EvgeniyaGo/Evgeniya-Golubeva-ADHD-Trainer/electrical_schematic.png

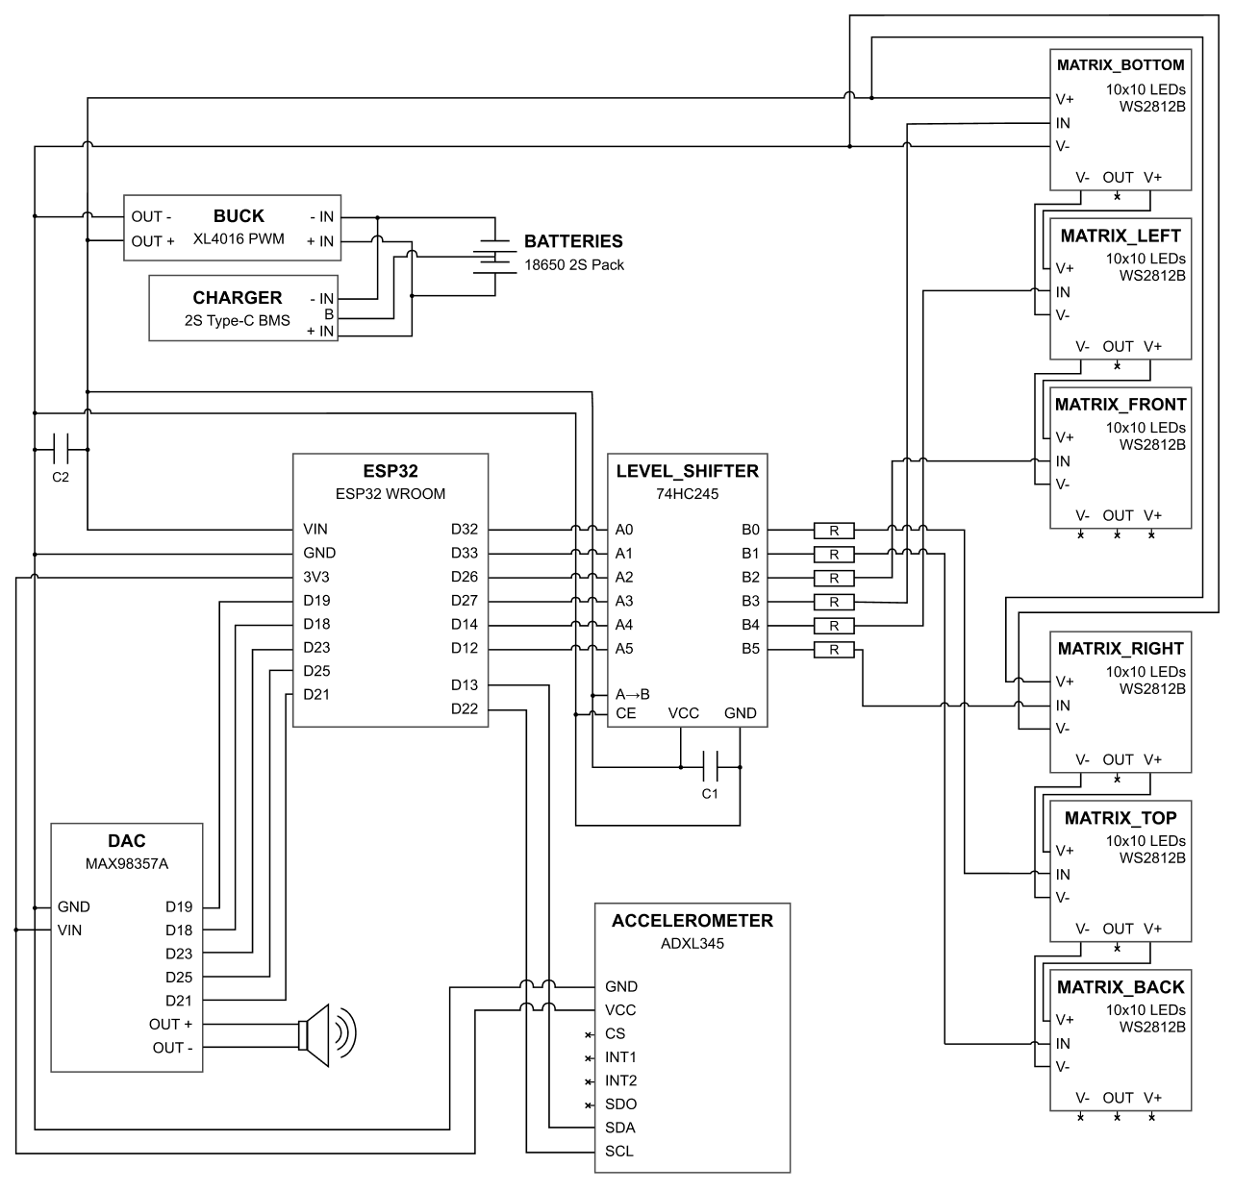
electrical_schematic.png
