EvgeniyaGo/Evgeniya-Golubeva-ADHD-Trainer/PCB/base-schematic-V3/base-schematic-02.kicad_pcb

## KiCad design PCB/base-schematic-V3/base-schematic-02.kicad_pcb (2026-01-03)

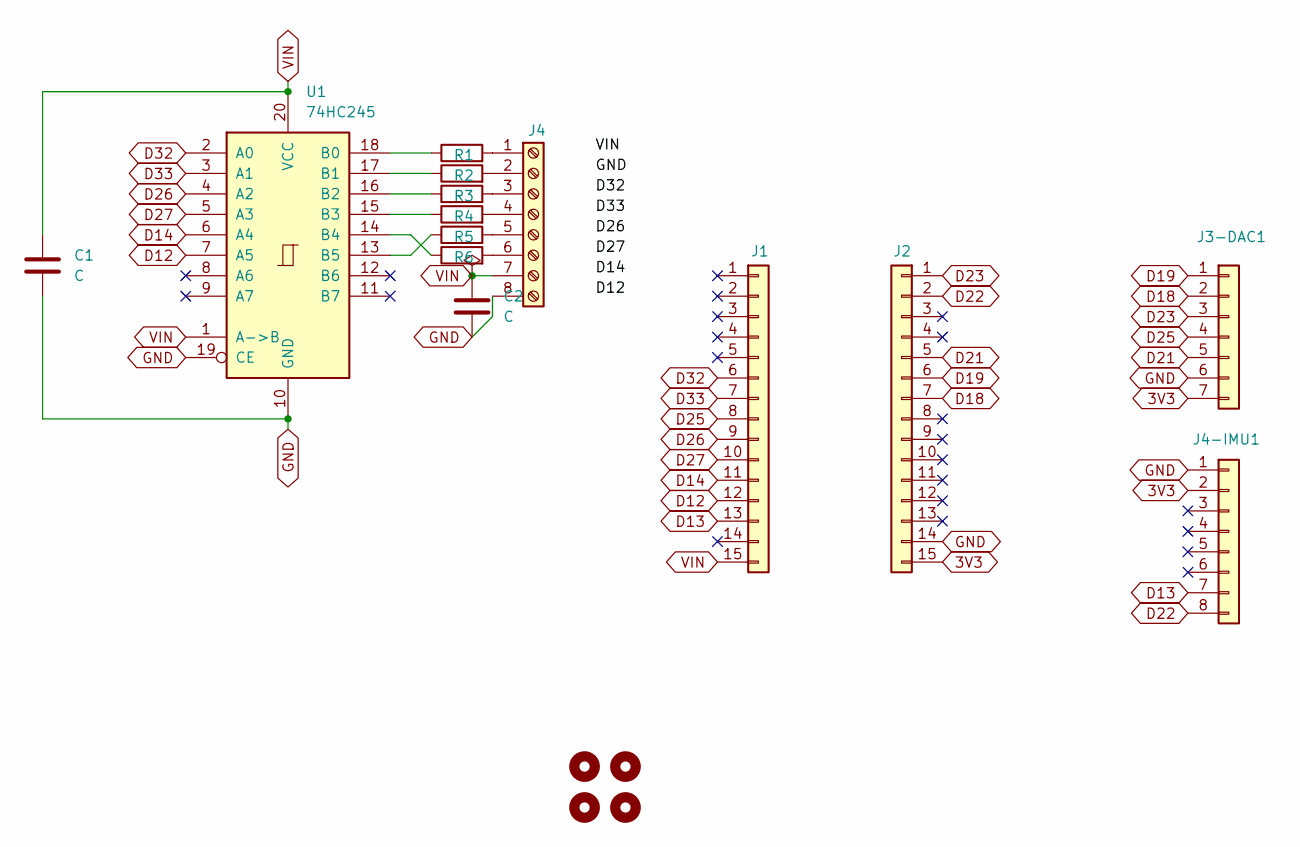
[picture p2: schematic base-schematic-02.kicad_sch]

Parts:
C1: C; C_Disc_D5.0mm_W2.5mm_P2.50mm
C2: C; C_Radial_D10.0mm_H20.0mm_P5.00mm
H1, H2, H3, H4: MountingHole; MountingHole_3.2mm_M3
J1, J2: Conn_01x15; PinSocket_1x15_P2.54mm_Vertical
J3-DAC1: Conn_01x07; PinSocket_1x07_P2.54mm_Vertical
J4: Screw_Terminal_01x08; TerminalBlock_Phoenix_PT-1,5-8-3.5-H_1x08_P3.50mm_Horizontal
J4-IMU1: Conn_01x08; PinSocket_1x08_P2.54mm_Vertical
R1, R2, R3, R4, R5, R6: R; R_Axial_DIN0207_L6.3mm_D2.5mm_P7.62mm_Horizontal
U1: 74HC245; DIP-20_W7.62mm_LongPads

Connections:
3V3: J2.15, J3-DAC1.7, J4-IMU1.2
D12: J1.12, U1.7 (A5)
D13: J1.13, J4-IMU1.7
D14: J1.11, U1.6 (A4)
D18: J2.7, J3-DAC1.2
D19: J2.6, J3-DAC1.1
D21: J2.5, J3-DAC1.5
D22: J2.2, J4-IMU1.8
D23: J2.1, J3-DAC1.3
D25: J1.8, J3-DAC1.4
D26: J1.9, U1.4 (A2)
D27: J1.10, U1.5 (A3)
D32: J1.6, U1.2 (A0)
D33: J1.7, U1.3 (A1)
GND: C1.2, C2.2, J2.14, J3-DAC1.6, J4.8, J4-IMU1.1, U1.10 (GND), U1.19 (CE)
unnamed: J4.1, R1.2
unnamed: J4.2, R2.2
unnamed: J4.3, R3.2
unnamed: J4.4, R4.2
unnamed: J4.5, R5.2
unnamed: J4.6, R6.2
unnamed: R1.1, U1.18 (B0)
unnamed: R2.1, U1.17 (B1)
unnamed: R3.1, U1.16 (B2)
unnamed: R4.1, U1.15 (B3)
unnamed: R6.1, U1.14 (B4)
unnamed: R5.1, U1.13 (B5)
VIN: C1.1, C2.1, J1.15, J4.7, U1.1 (A->B), U1.20 (VCC)

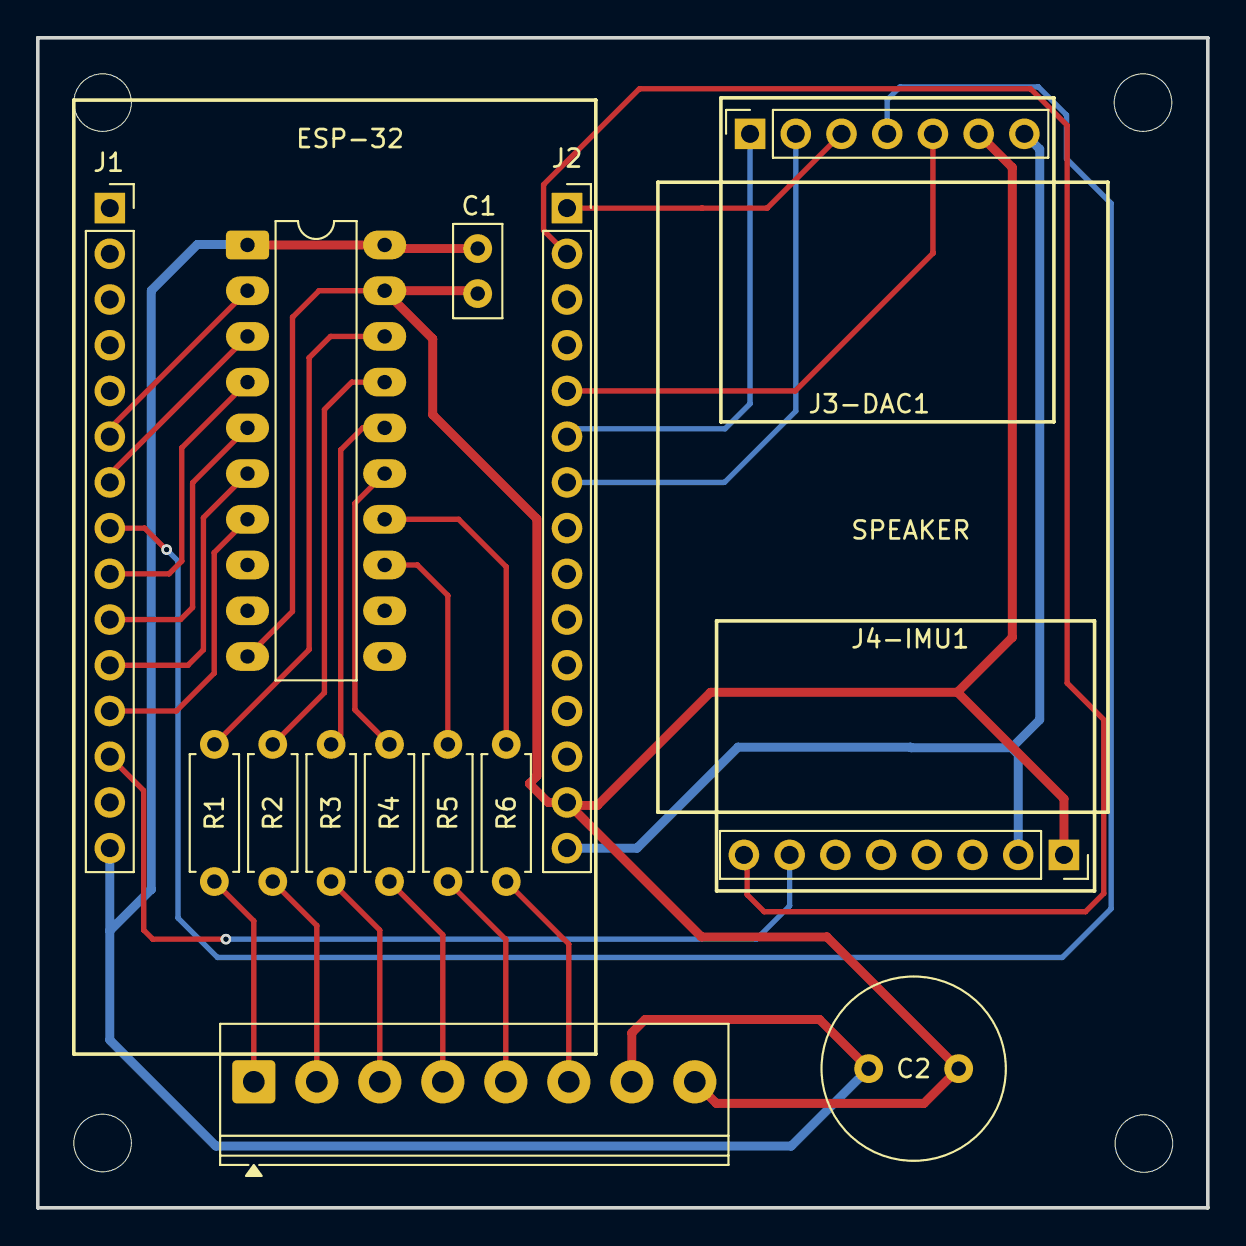
[picture p3: board base-schematic-02.kicad_pcb from above]

Board: 2 copper layers, 65.0 x 65.0 mm, 18 parts (0 on the bottom side), 28 nets.
