EvgeniyaGo/Evgeniya-Golubeva-ADHD-Trainer/init_esp_code/main/audio.h

#pragma once
#include <Arduino.h>

// Audio events 
enum AudioEvent {
  AUDIO_ROUND_START,
  AUDIO_SUCCESS,
  AUDIO_FAIL,
  AUDIO_SNAKE_APPLE,
  AUDIO_SNAKE_GAME_OVER
};

// Public API 
void audio_init();
void audio_playBeep(uint16_t freq, uint16_t duration_ms);
void audio_playEvent(AudioEvent e); // not used for now but might be useful later
bool parseKeyValueInt(const String &cmd, const char *key, uint16_t &out);
