EvgeniyaGo/Evgeniya-Golubeva-ADHD-Trainer/(commit log)

2025-10-11 ESP32 first connection success
    first TX/RX connection with phone via nRF. Did not see the name of the board, but figured out which is it by the rate of ~20ms, which is low enough for the distance.
    Next - make sure the board ahs a proper name and go to making the app.
2025-10-13 Connects to react without a problem
    Now with the code rewritten, it connects to the phone without problems. It also displays as Jeni-ESP32.
2025-10-13 Init the app and edited App.tsx to establish communication w/ ESP and showcase it via echo
    The result is something along the lines of:
    [BLE] Connected to Jeni-ESP32
    [→ ESP] "hello\n"
    [ESP →] hello
2025-10-27 Which face is facing upwards algorithm
    Will be needed later for checking motion and submitting answers.
    - Almost none to none noise
    - Based on an MPU6050 (might change later but the code should remain almost the same)
    Recognizes which face is upwards and, when it has changed, writes a new print into serial.
    Next step is the shake recognition.
2025-11-01 Box with 6 leds (stage 1)
    Mimiccing the box movement detection
2025-11-01 Box lightning up via IMU movement
    Implement ADXL345-based face detection and LED orientation display
2025-11-02 Led control of the cube from App
    Now I have a boolean that works as an "app-permission". When the app sends a signal, this puts the boolean to the opposite value. The whole led control is put inside an if, depending on this value.
    Also, there is a communication esp -> app via sending to the app state of each side boolean (led_up and so on) each ~4 seconds.
2025-11-05 App main screen prototype for desktop and mobile beautification
2025-11-05 Combine imu and led code with matrix
2025-11-06 Working 2-display imu-to-display orientation game
    Each trial chooses a target face (random) and shows a small 2×2 square on that face.
    Headstart (2s): just a cue/preamble; no penalties. (We still display the small square.)
    Discovery window (5s): player must get the target face up at least once before t = 7s.
    Hold (3s continuous): once started, the face must remain up without breaking.
    Feedback (3s): Success → enlarge square to a bigger block (e.g., 4×4) in green for 3s. Fail → enlarge square to red for 3s.
    Loop to next trial.
2025-11-16 6 Sides of the cube are on
    - Making a v2 prototype with 6 sides lighting up
2025-12-22 Small finishes by different topics
    - Speaker
    - IMU
    - Display controls
    - Diffusers
2026-01-03 PCB creations
    [base-schematic-02-B_Cu.gbl, base-schematic-02-B_Mask.gbs, base-schematic-02-B_Paste.gbp, base-schematic-02-B_Silkscreen.gbo, base-schematic-02-Edge_Cuts.gm1, base-schematic-02-F_Cu.gtl, base-schematic-02-F_Mask.gts, base-schematic-02-F_Paste.gtp]
2026-01-23 Cube positioning fixing (pointing one side to another)
    [display_control.h, display_control.ino, imu_control.h, imu_control.ino, main.ino, shape_definitions.h, types.h]
2026-01-23 Move arrow logic to server code. Create a clear all. Fix overlays.
    [main.ino]
2026-01-24 Got start round to work, end round stilll in process
    START ROUND manually works
    At rounds end esp sends an END ROUND
    Server gets:
    [ESP →] END ROUND LEFT
    [ESP →] [45 4e 44 20 52 4f 55 4e 44 20 4c 45 46 54 0a]
    So a weird hex is there. And the server does not send another command to "run next round."
2026-01-30 Auto round start for n remaining with side consistency and working end round
    [→ ESP] "ROUND START type=ARROW from=TOP to=Right duration=800 remaining=5"
    [ESP →] OK ROUND START
    [ESP →] ROUND BALANCE side=RIGHT
    [→ ESP] "CLEAR ALL"
    [→ ESP] "DRAW SHAPE RIGHT SHAPE_ARROW_RIGHT COLOR_BLUE"
    [→ ESP] "DRAW SHAPE RIGHT SHAPE_CIRCLE_6X6 COLOR_GREEN"
    [ESP →] OK CLEAR ALL
    [ESP →] OK DRAW SHAPE
    [ESP →] OK DRAW SHAPE
    [ESP →] END ROUND RIGHT
    [→ ESP] "ROUND START type=ARROW from=RIGHT to=BOTTOM duration=800 remaining=4"
    [ESP →] OK ROUND START
    [ESP →] ROUND BALANCE side=RIGHT
    [→ ESP] "CLEAR ALL"
    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
2026-01-30 round errors now return success/fail and reason + time
    [main.ino]
2026-01-31 Fix countdown sequencing, add a PAUSE logic, and make all round invariants work
    [main.ino]
2026-02-03 Add opposite side (Dimon says) game mode logic + Fix the ESP not appearing when powered from battery
    [audio.ino, main.ino]
2026-02-03 Fix opposite side logic for Dimon says
    [main.ino]
2026-02-04 Make the gameflow smooth and no bugs during it
    [main.ino]
2026-02-04 Debuged game flow. Added game start and game end commands
2026-02-05 Rewriring for V3 PCB + Adaptive difficulty through time
2026-02-05 Fixíng the countdown on front flickering
    Slowly rebuilding the loop on the bottom
    [display_control.ino, main.ino]
2026-02-05 Countdown on ble fixed (still have to rewrite the real loop)
    [display_control.ino, main.ino]
2026-02-06 Fixing issues with signals to player (beep, arrow, expected face)
    1. Cannot recognize the BEEP command (BEEP freq=... dur=...) - gives error command
    2. When server sends "draw arrow" it doesnt draw it. It draws the circle however. Maybe its because the arrow is on the side that the countdown is on?
    3. I get result=success on face=front where we are expecting right It appears that the face that is considered success is the "from" not expected nor to. [6:39:22 PM] [→ ESP] "ROUND START type=ARROW from=FRONT to=RIGHT expected=RIGHT duration=8292 remaining=3" [6:39:22 PM] [ESP →] ROUND BALANCE side=FRONT [6:39:22 PM] [→ ESP] "CLEAR ALL" [6:39:22 PM] [→ ESP] "DRAW SHAPE FRONT SHAPE_ARROW_R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
    [display_control.ino, main.ino]
2026-02-07 Fixed the countdown, now it follows the upFace on type ARROW
    [display_control.ino, main.ino]
2026-02-07 Fixing round balance being updated too much and sending face=Unknown
    [main.ino]
2026-02-07 Fixing flickering screen back->top movement and back mirroring top
    [display_control.ino, main.ino]
2026-02-09 Fixed clearing on round start
    [main.ino]
2026-02-15 PCB folder cleanup
    [base-schematic-02-B_Cu.gbl, base-schematic-02-B_Mask.gbs, base-schematic-02-B_Paste.gbp, base-schematic-02-B_Silkscreen.gbo, base-schematic-02-Edge_Cuts.gm1, base-schematic-02-F_Cu.gtl, base-schematic-02-F_Mask.gts, base-schematic-02-F_Paste.gtp]
2026-02-17 Adding electrical schematic
2026-05-11 Fixes to snake game - audio, faces
    [audio.h, audio.ino, display_control.h, display_control.ino, main.ino]
2026-05-17 Reconnect app and cube and add some reimplementation of the protocol
    This took too long I am going insane please send help why is my pending round structure so f-ed up...
    [display_control.h, main.ino]
